garvita4/multi-purpose-organiser/images/ROTATINGSMALL.png

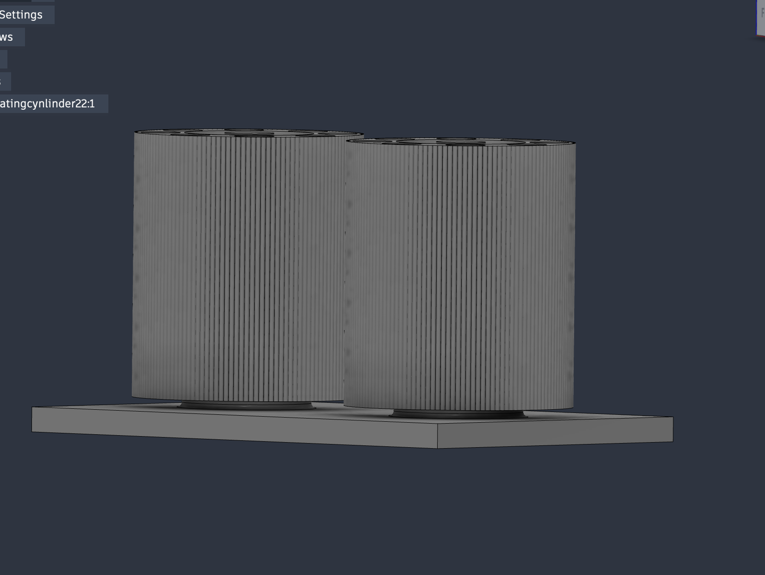
images/ROTATINGSMALL.png
