garvita4/multi-purpose-organiser/images/ROTATINGSMALLATTACHEMENT.png

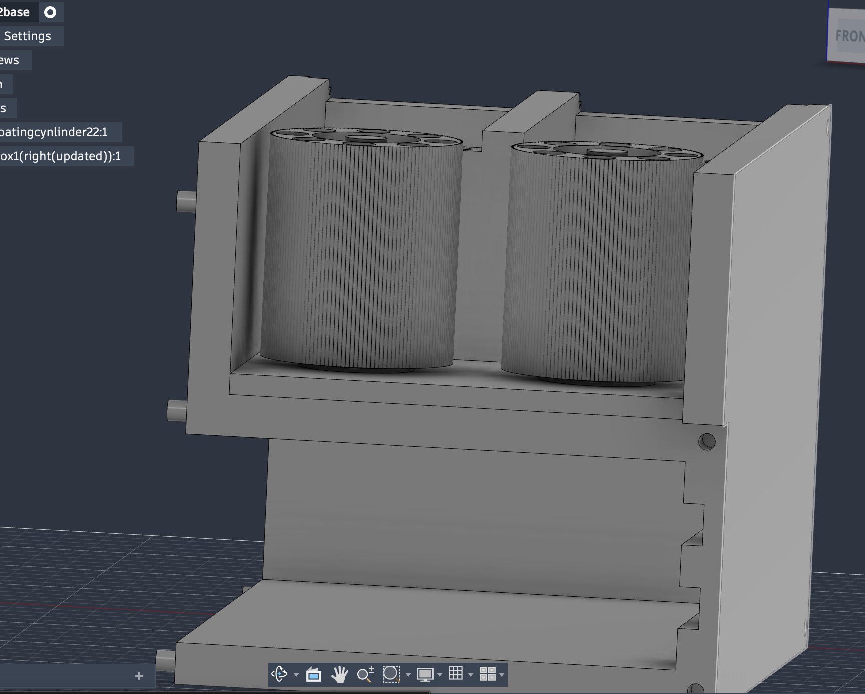
images/ROTATINGSMALLATTACHEMENT.png
