garvita4/multi-purpose-organiser/BOM.csv

Item | Qty | Supplier | Cost/item | Total Cost | link
6000 ZZ Bearing | 6 | onlyscrews | $0.19 | $1.14 | https://onlyscrews.in/products/6000-zz-deep-groove-ball-bearing-10x26x8
Magnet(4mm X 2mm) | 40 | onlyscrews | $0.07 | $2.80 | https://onlyscrews.in/products/4mm-diameter-neodymium-disc-magnets-n35?variant=51058762219833
M3 Brass Heatset | 20 | onlyscrews | $0.05 | $1.00 | https://onlyscrews.in/products/m3-x-4mm-3d-printing-brass-threaded-inserts-dia-3mm-length-4mm
Super Glue | 2 | onlyscrews | $0.47 | $0.94 | https://onlyscrews.in/products/kwality-777-non-whitening-extremely-strong-bonding-adhesive-20g
M3 Screw Set | 1 | onlyscrews | $2.21 | $2.21 | https://onlyscrews.in/products/m3-phillips-countersunk-ss304-assorted-box
Estimated total shipping | 1 |  |  | $0.00
