garvita4/multi-purpose-organiser/CAD/production/MAINBOXCOVER(BOTTOM).step

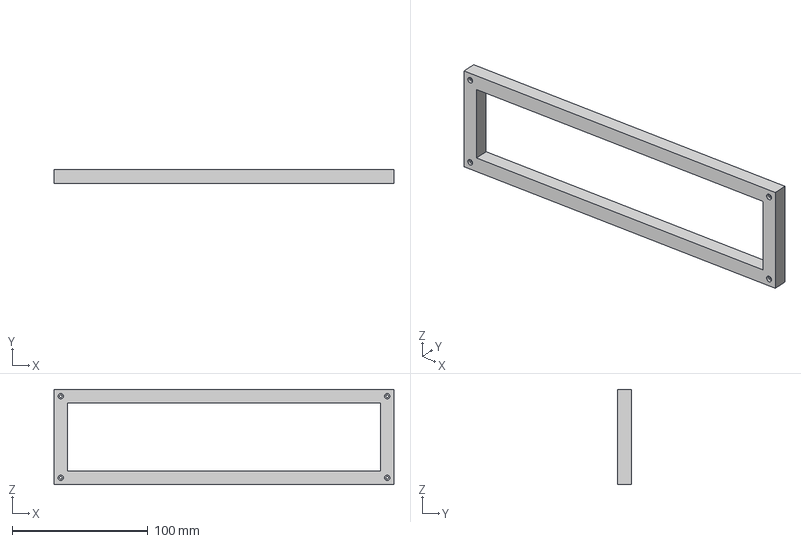
[picture p17: CAD file, 2026-10-18]
CAD/production/MAINBOXCOVER(BOTTOM).step
250.0 x 10.0 x 70.0 mm
