garvita4/multi-purpose-organiser/CAD/production/MAINBOX(right).step

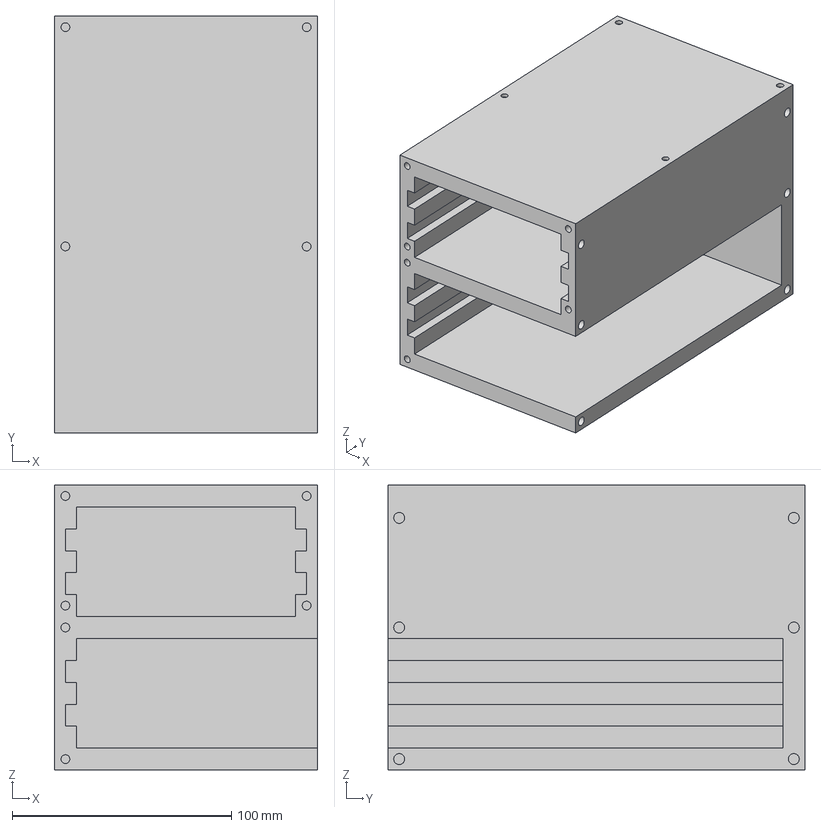
[picture p18: CAD file, 2026-10-18]
CAD/production/MAINBOX(right).step
120.0 x 190.0 x 130.0 mm
