garvita4/multi-purpose-organiser/CAD/production/MAINBOXHINGECOVER.step

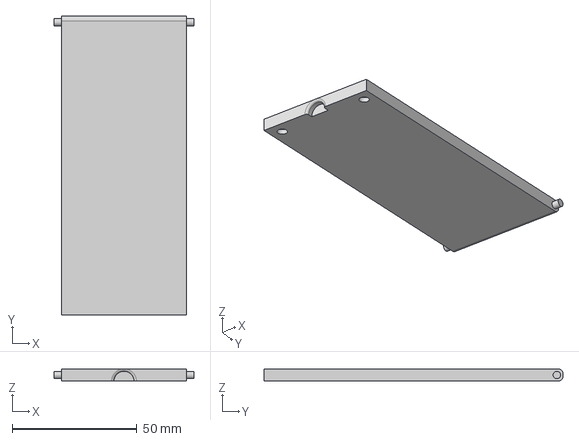
[picture p19: CAD file, 2026-10-18]
CAD/production/MAINBOXHINGECOVER.step
56.0 x 120.0 x 5.00 mm
