garvita4/multi-purpose-organiser/CAD/production/MAINBIGDRAWER(left).step

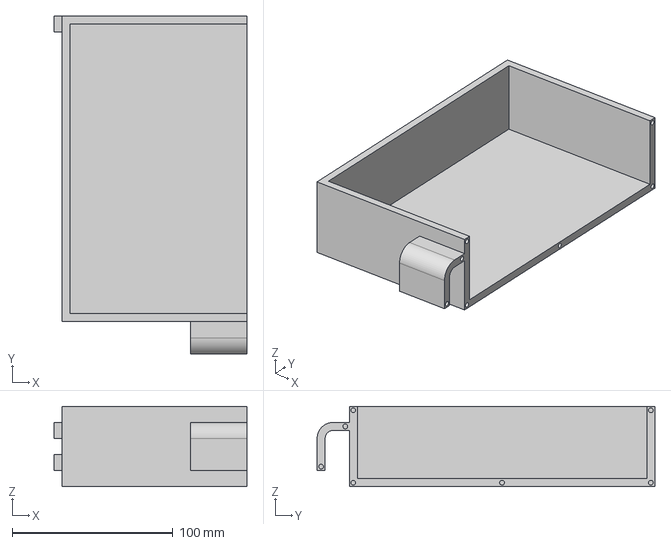
[picture p20: CAD file, 2026-10-18]
CAD/production/MAINBIGDRAWER(left).step
120.0 x 210.0 x 50.0 mm
