garvita4/multi-purpose-organiser/CAD/production/MAINBOX(left).step

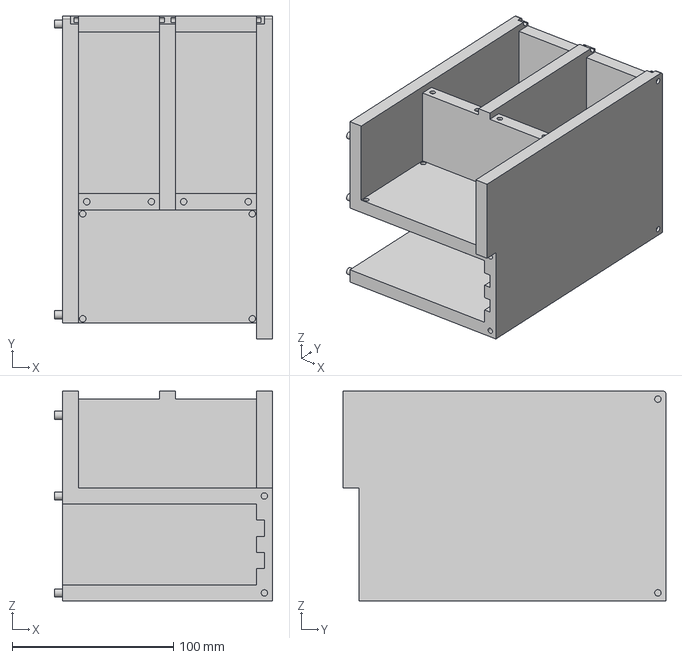
[picture p21: CAD file, 2026-10-18]
CAD/production/MAINBOX(left).step
135.0 x 200.0 x 130.0 mm
