garvita4/multi-purpose-organiser/CAD/production/MAINBOXSMALLDRAWER.step

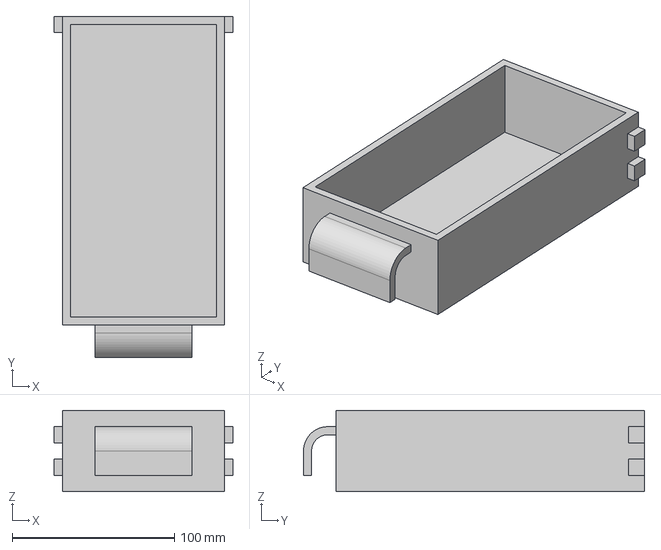
[picture p22: CAD file, 2026-10-18]
CAD/production/MAINBOXSMALLDRAWER.step
110.0 x 210.0 x 50.0 mm
