garvita4/multi-purpose-organiser/CAD/production/MAINBOXCOVER(top).step

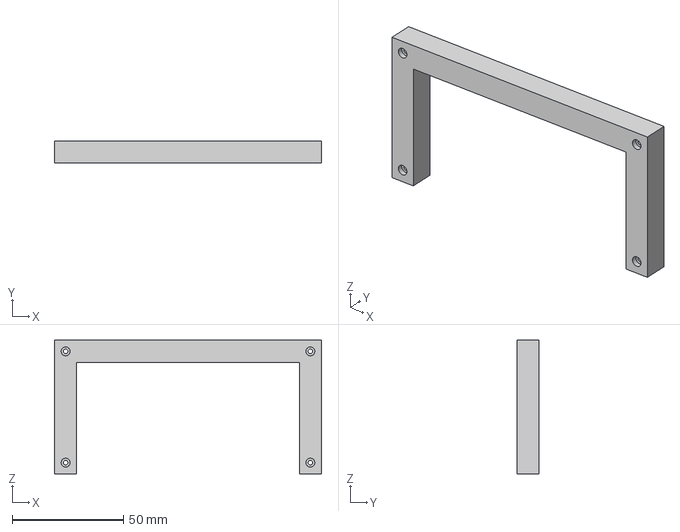
[picture p23: CAD file, 2026-10-18]
CAD/production/MAINBOXCOVER(top).step
120.0 x 10.0 x 60.0 mm
