garvita4/multi-purpose-organiser/CAD/design/FINAL.stl

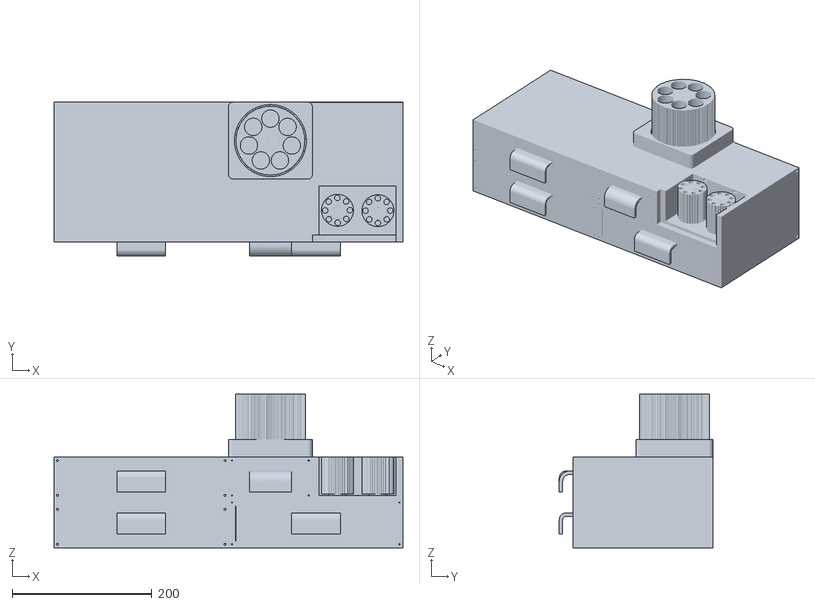
[picture p24: CAD file, 2026-10-18]
CAD/design/FINAL.stl
500.0 x 220.0 x 220.0
