garvita4/multi-purpose-organiser/CAD/production/BOX2(right).step

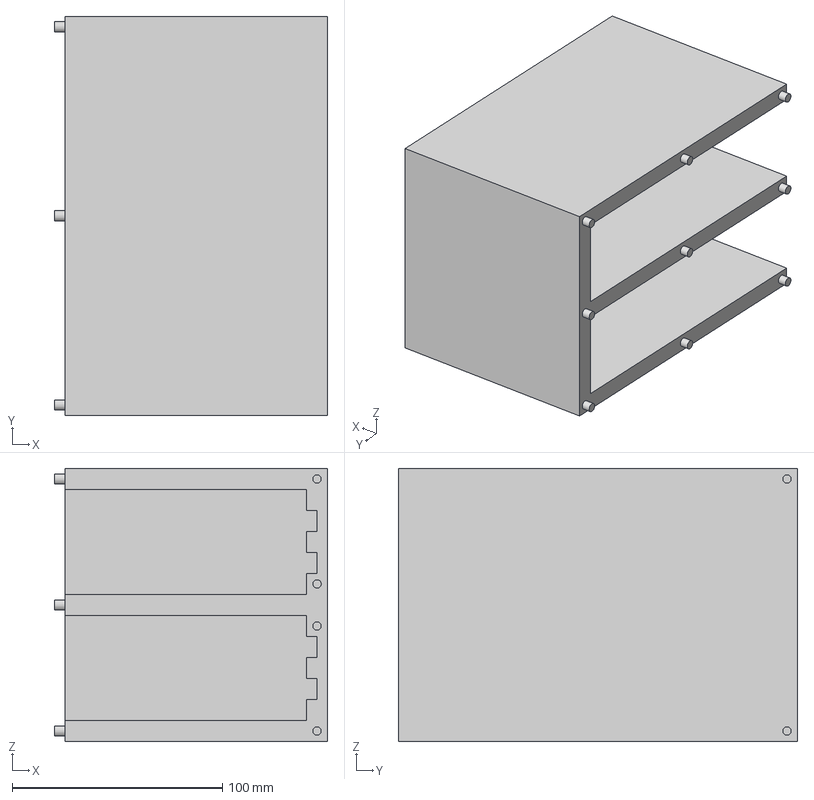
[picture p25: CAD file, 2026-10-18]
CAD/production/BOX2(right).step
130.0 x 190.0 x 130.0 mm
