garvita4/multi-purpose-organiser/CAD/production/BOX2COVER.step

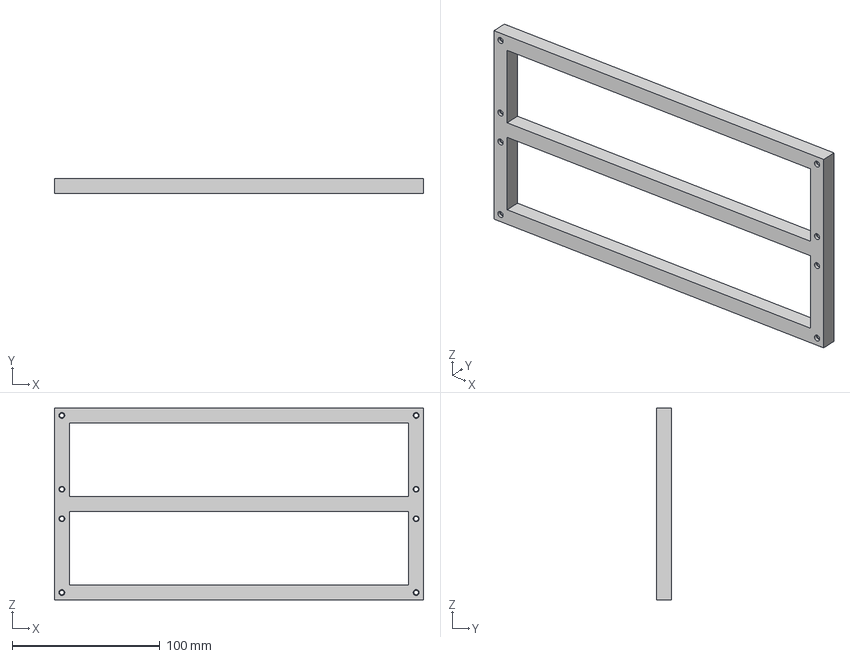
[picture p26: CAD file, 2026-10-18]
CAD/production/BOX2COVER.step
250.0 x 10.0 x 130.0 mm
