garvita4/multi-purpose-organiser/CAD/production/ROTATINGBODY(big).step

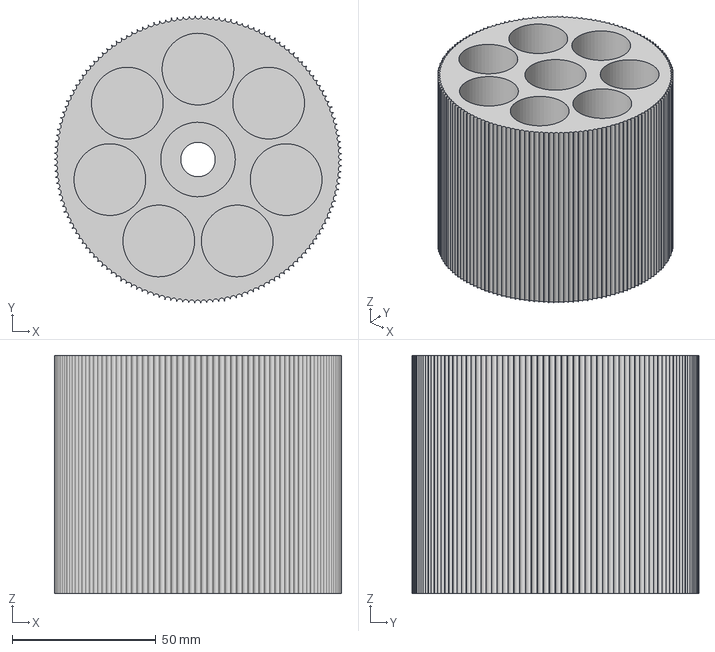
[picture p27: CAD file, 2026-10-18]
CAD/production/ROTATINGBODY(big).step
100.0 x 100.0 x 83.0 mm
