garvita4/multi-purpose-organiser/CAD/production/HINGELOCK(middle).step

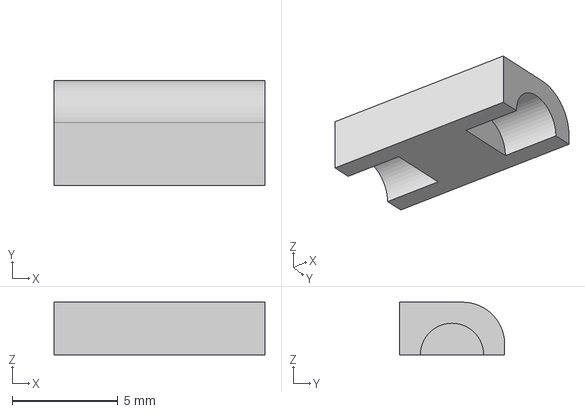
[picture p28: CAD file, 2026-10-18]
CAD/production/HINGELOCK(middle).step
10.0 x 5.00 x 2.50 mm
