garvita4/multi-purpose-organiser/CAD/production/HINGELOCK(left).step

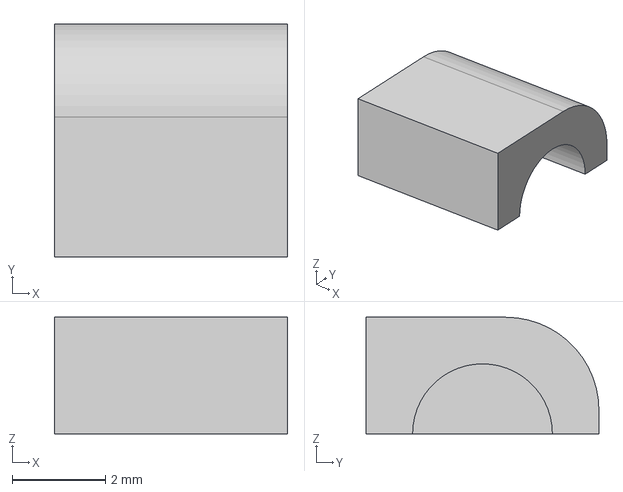
[picture p29: CAD file, 2026-10-18]
CAD/production/HINGELOCK(left).step
5.00 x 5.00 x 2.50 mm
