garvita4/multi-purpose-organiser/CAD/production/ROTATINGBODY(small).step

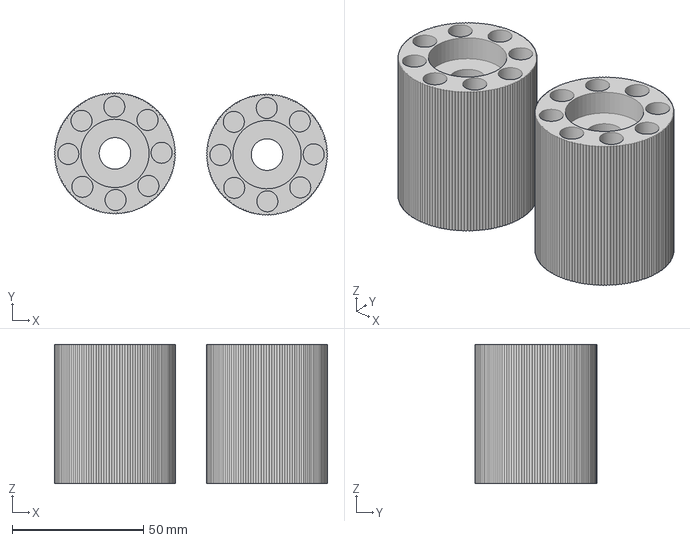
[picture p30: CAD file, 2026-10-18]
CAD/production/ROTATINGBODY(small).step
103.9 x 46.5 x 53.0 mm
