garvita4/multi-purpose-organiser/CAD/production/BOX2DRAWER(left).step

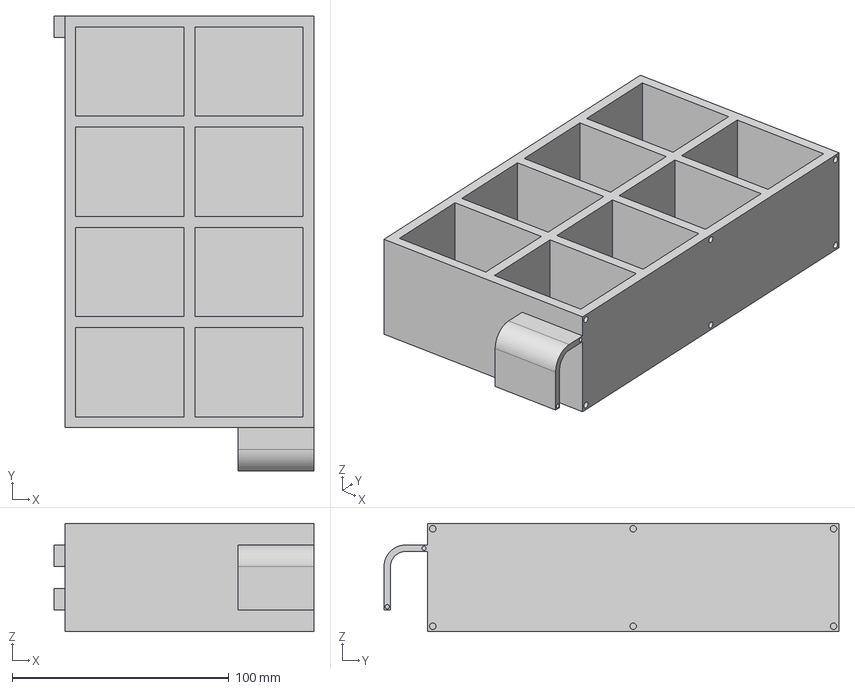
[picture p31: CAD file, 2026-10-18]
CAD/production/BOX2DRAWER(left).step
120.0 x 210.0 x 50.0 mm
