garvita4/multi-purpose-organiser/CAD/production/ROTATINGROD(small).step

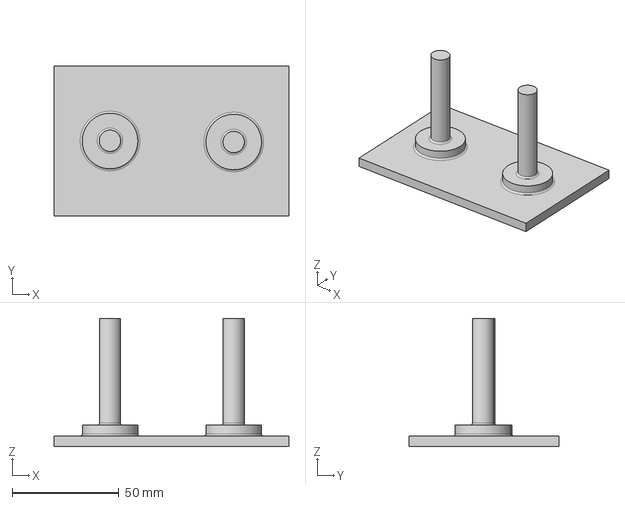
[picture p32: CAD file, 2026-10-18]
CAD/production/ROTATINGROD(small).step
110.0 x 70.0 x 60.0 mm
