garvita4/multi-purpose-organiser/CAD/production/ROTATINGROD(big).step

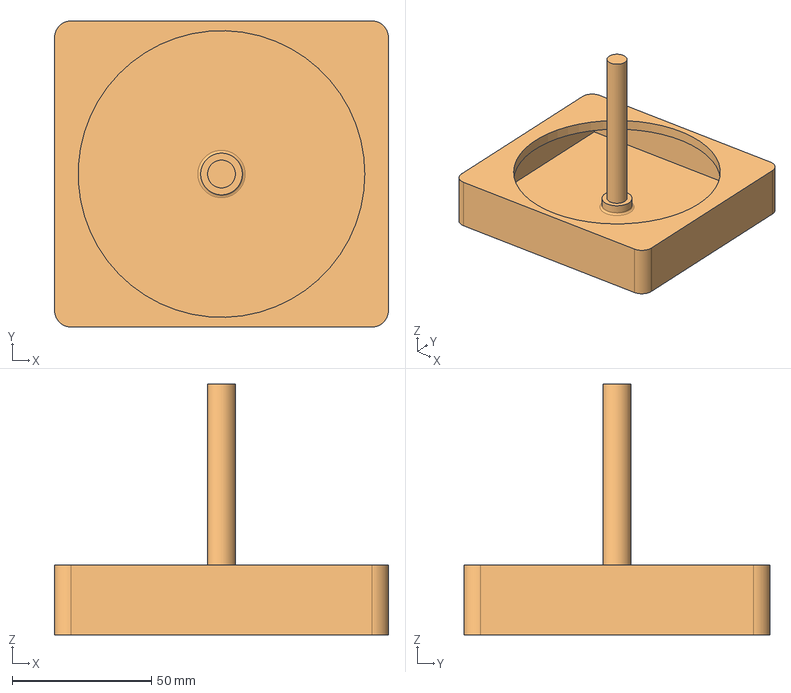
[picture p33: CAD file, 2026-10-18]
CAD/production/ROTATINGROD(big).step
120.0 x 110.0 x 90.0 mm
