garvita4/multi-purpose-organiser/CAD/production/BOX2(left).step

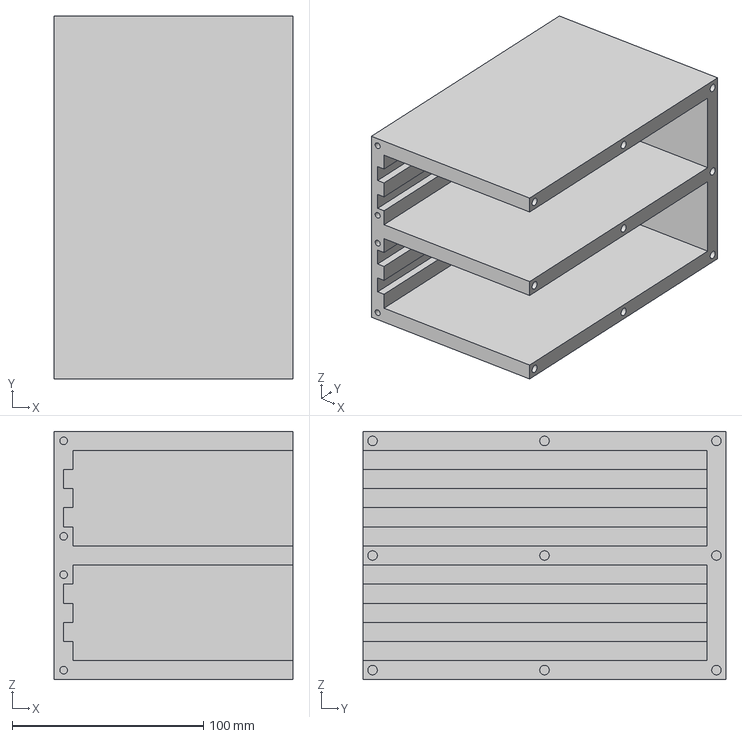
[picture p34: CAD file, 2026-10-18]
CAD/production/BOX2(left).step
125.0 x 190.0 x 130.0 mm
