garvita4/multi-purpose-organiser/(list of files, cad)

Other CAD files:
CAD/production/MAINBIGDRAWER(right).step
CAD/production/BOX2DRAWER(right).step
CAD/production/HINGELOCK(right).step
CAD/design/FINAL.f3z
