garvita4/multi-purpose-organiser/JOURNAL.md

# organizer – devlog

<!-- Generated by Half Life from project cmv985js501b901r9shhi05jy. Edits here are overwritten on the next sync. -->
<!-- Generated: 2026-10-18T15:05:48.324Z -->

> [!NOTE]
> This devlog is mirrored from [Half Life](https://halflife.hackclub.com) – [open the project](https://halflife.hackclub.com/projects/cmv985js501b901r9shhi05jy). Editing it here will not change the platform's copy, and the next sync overwrites this file.

> an organizer for your desk

| Week | Tier | Hours logged | Entries |
| --- | --- | --- | --- |
| Week 2 | Tier 1 | 9.79h | 6 |

## Contents

1. [2026-10-17 – Work session](#2026-10-17-work-session)
2. [2026-10-17 – Work session](#2026-10-17-work-session)
3. [2026-10-17 – Work session](#2026-10-17-work-session)
4. [2026-10-18 – Work session](#2026-10-18-work-session)
5. [2026-10-18 – Work session](#2026-10-18-work-session)
6. [2026-10-18 – Work session](#2026-10-18-work-session)

## Design

### 2026-10-17 – Work session

**1.82h**

[Timelapse](https://lookout.hackclub.com/api/media/8ff08c43-e10a-45fd-936b-515f94e3e3f1/video.mp4)

### 2026-10-17 – Work session

**2.17h**

[Timelapse](https://lookout.hackclub.com/api/media/5e56af52-0a3e-452f-99dd-7f03cff50a99/video.mp4)

[Timelapse](https://lookout.hackclub.com/api/media/ad8b9acd-e0d3-4f8c-918a-c391cf19f0a8/video.mp4)

### 2026-10-17 – Work session

**1.33h**

[Timelapse](https://lookout.hackclub.com/api/media/0f275682-289b-4d2a-b921-bf5aa1ebfcee/video.mp4)

[Timelapse](https://lookout.hackclub.com/api/media/4c1c5811-00ca-4e93-9443-f551114be958/video.mp4)

### 2026-10-18 – Work session

**1.52h**

[Timelapse](https://lookout.hackclub.com/api/media/84ea2b09-e6b9-4155-bf9b-4b33f442a077/video.mp4)

[Timelapse](https://lookout.hackclub.com/api/media/7ba18462-793a-4767-a1a0-b34a49adad33/video.mp4)

### 2026-10-18 – Work session

**1.72h**

[Timelapse](https://lookout.hackclub.com/api/media/768327f0-e212-428e-a1fd-5f9137e8fbb2/video.mp4)

[Timelapse](https://lookout.hackclub.com/api/media/f626b1b8-18bf-45b1-ace4-2303cac74bdb/video.mp4)

### 2026-10-18 – Work session

**1.23h**

[Timelapse](https://lookout.hackclub.com/api/media/c90fd0d8-3d36-4ed9-bcbc-9b80f2785402/video.mp4)

[Timelapse](https://lookout.hackclub.com/api/media/60ada85d-39ce-4b37-bc6c-b26757286c95/video.mp4)
