garvita4/multi-purpose-organiser/(commit log)

2026-10-18 Initial commit: art supplies organizer
    [BOX2(left).step, BOX2(right).step, BOX2COVER.step, BOX2DRAWER(left).step, BOX2DRAWER(right).step, Bom.csv, FINAL.f3z, FINAL.stl]
2026-10-18 Sync organizer from Half Life
    [BOM.csv]
